Simmetrik/6DOF-Motion-Platform/README.md

# 6DOF Motion Simulator Platform

Open source DIY 6DOF Motion Simulator Platform http://www.simmetrik.com/6dof-motion-simulator-platform

Bill of materials: https://docs.google.com/spreadsheets/d/1yukbHEX3OOh7PhPTMxNBAHjRlY-1jp8z9QsD87R0PGY/edit?usp=sharing
