Simmetrik/6DOF-Motion-Platform/AASD15A Rack/Rack for AASD15A drives.step

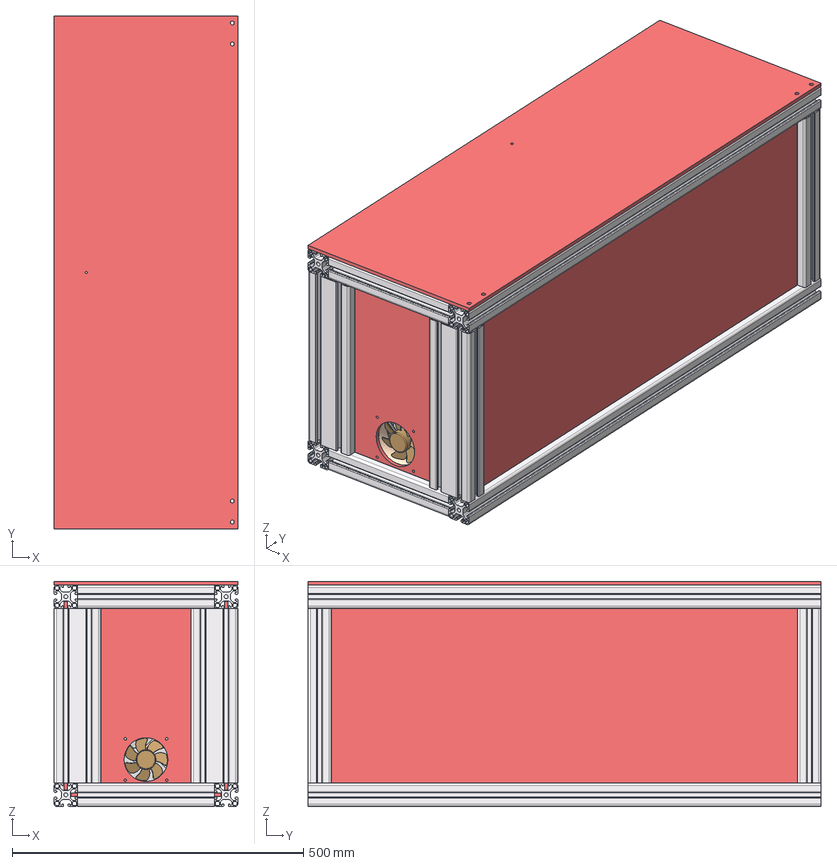
[picture p1: CAD file, 2021-11-13]
AASD15A Rack/Rack for AASD15A drives.step
315.0 x 880.0 x 386.0 mm
profile 40x40 (2) x 4
profile 80x40 (2) x 4
profile 40x40 (1) (2) (1) x 4
profile 40x40 (3)
profile 40x40 (4)
AASD15A Servo Drive (1)
AASD15A Servo Drive (7)
AASD15A Servo Drive (2)
AASD15A Servo Drive (6)
AASD15A Servo Drive (5)
AASD15A Servo Drive (4)
AASD15A Servo Drive (3)
Plexi x 2
Plexi (1)
Plexi (1) (1)
Plexi (1) (1) (2)
Plexi (1) (2)
Noctua nf-a8-pwm fan 80x80x25
Fan Baffle 80mm
