Simmetrik/6DOF-Motion-Platform/Double Traction Loss/DoubleTL UCF206 Mounting Plate.step

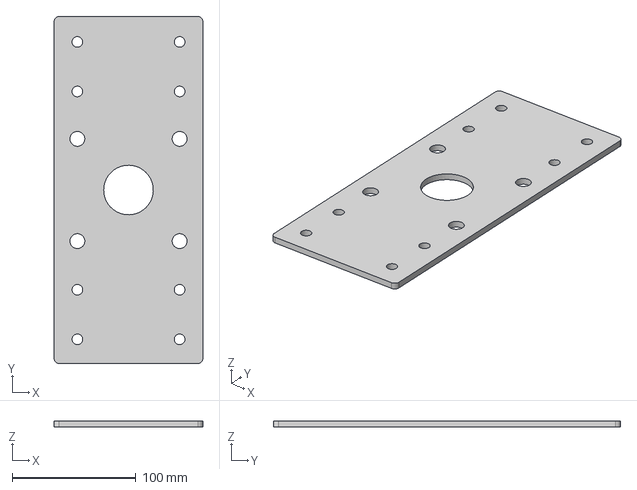
[picture p2: CAD file, 2021-11-13]
Double Traction Loss/DoubleTL UCF206 Mounting Plate.step
120.0 x 280.0 x 5.00 mm
