Simmetrik/6DOF-Motion-Platform/Surge/Surge Linear Rail Carriage Mount.step

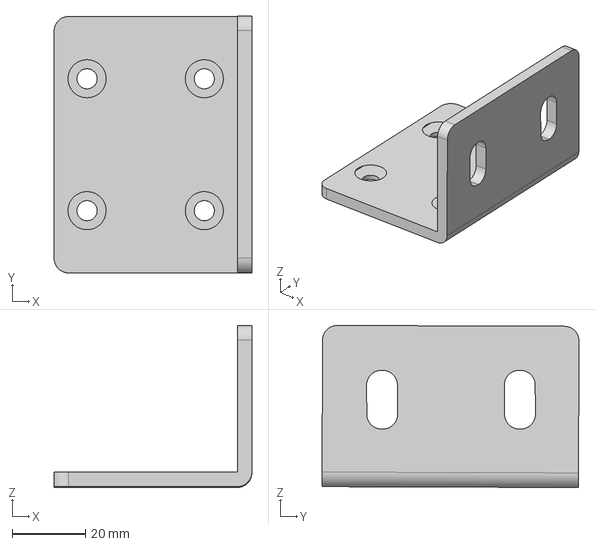
[picture p3: CAD file, 2021-11-13]
Surge/Surge Linear Rail Carriage Mount.step
54.0 x 70.1 x 44.2 mm
