Simmetrik/6DOF-Motion-Platform/Double Traction Loss/DoubleTL GX150 Linear Table Mount.step

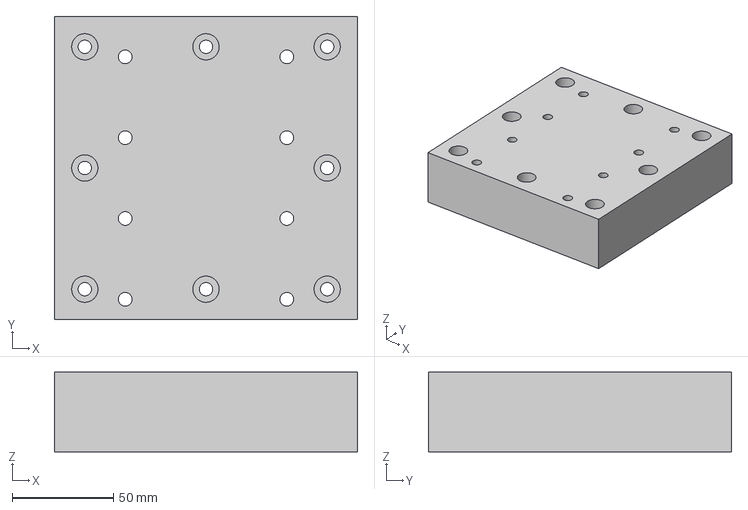
[picture p5: CAD file, 2021-11-13]
Double Traction Loss/DoubleTL GX150 Linear Table Mount.step
150.0 x 150.0 x 39.5 mm
