Simmetrik/6DOF-Motion-Platform/Surge/Surge Linear Rail Carriage Mount Spacer.step

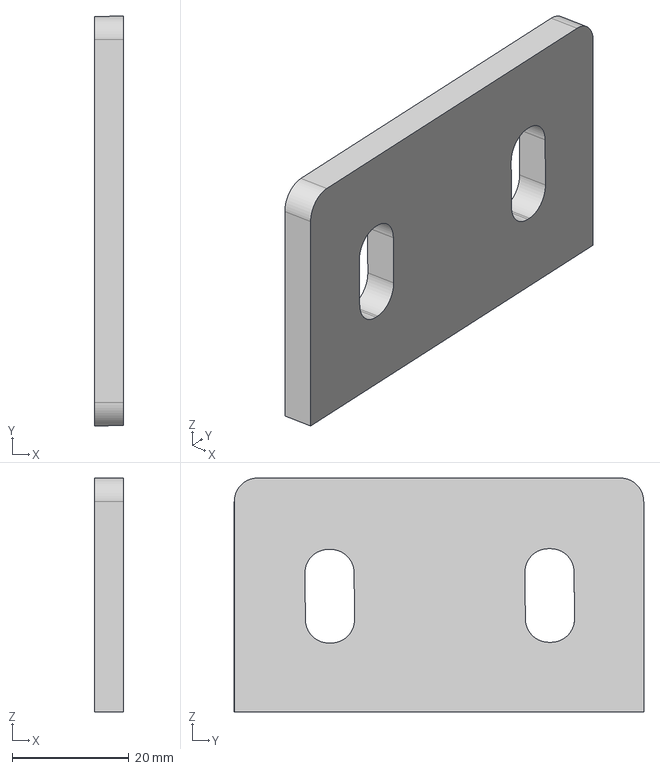
[picture p6: CAD file, 2021-11-13]
Surge/Surge Linear Rail Carriage Mount Spacer.step
5.00 x 70.0 x 40.0 mm
