Simmetrik/6DOF-Motion-Platform/Vertical Actuator/Vertical Actuator Fixed Bearing Mount CNC.step

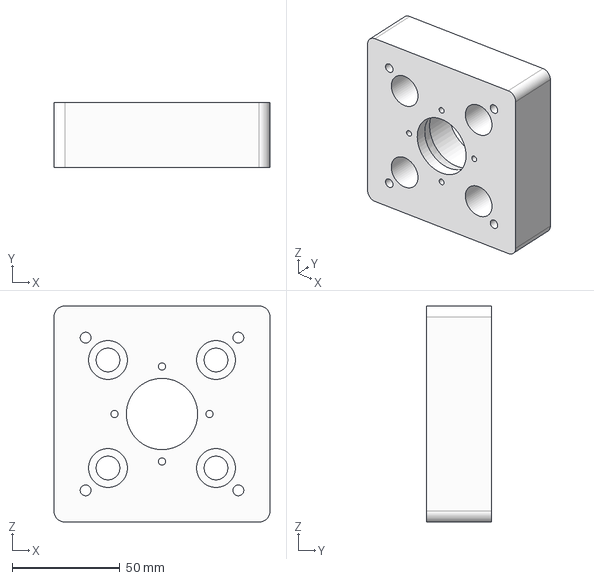
[picture p7: CAD file, 2021-11-14]
Vertical Actuator/Vertical Actuator Fixed Bearing Mount CNC.step
100.0 x 30.0 x 100.0 mm
