Simmetrik/6DOF-Motion-Platform/Double Traction Loss/DoubleTL UCF206 to SC25 Mounting Plate.step

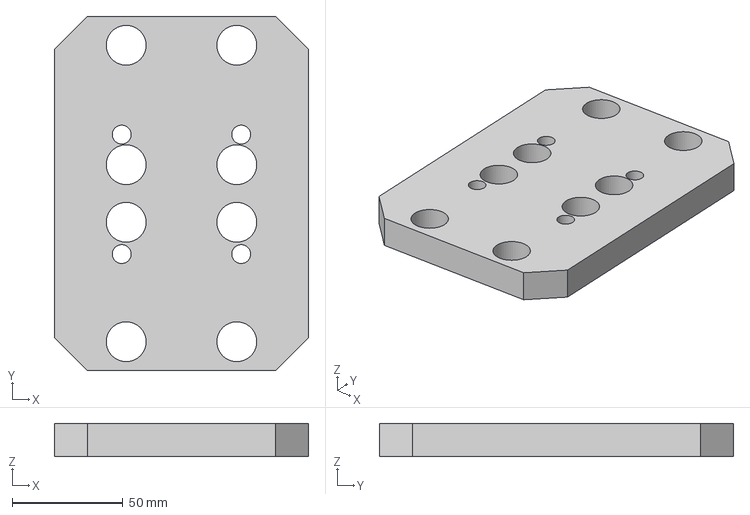
[picture p8: CAD file, 2021-11-13]
Double Traction Loss/DoubleTL UCF206 to SC25 Mounting Plate.step
115.0 x 160.0 x 15.0 mm
