Simmetrik/6DOF-Motion-Platform/Surge/Surge GX150 Linear Table Mount.step

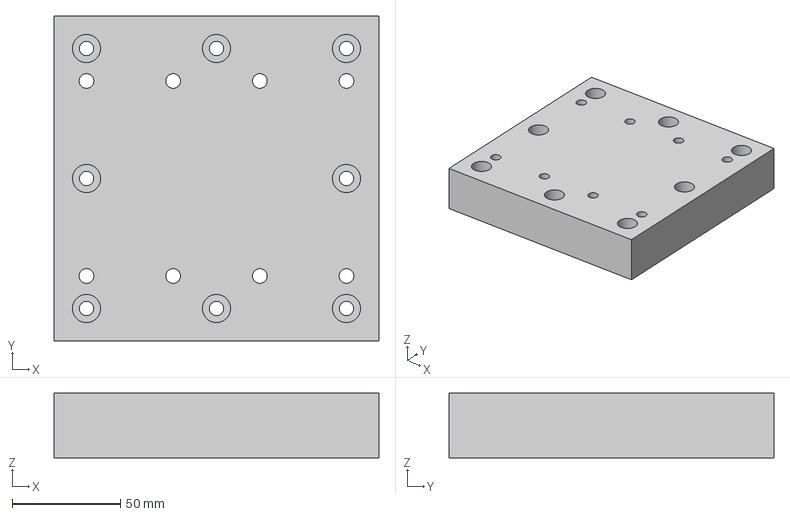
[picture p9: CAD file, 2021-11-13]
Surge/Surge GX150 Linear Table Mount.step
150.0 x 150.0 x 30.0 mm
