Simmetrik/6DOF-Motion-Platform/Vertical Actuator/Vertical Actuator Ball End.step

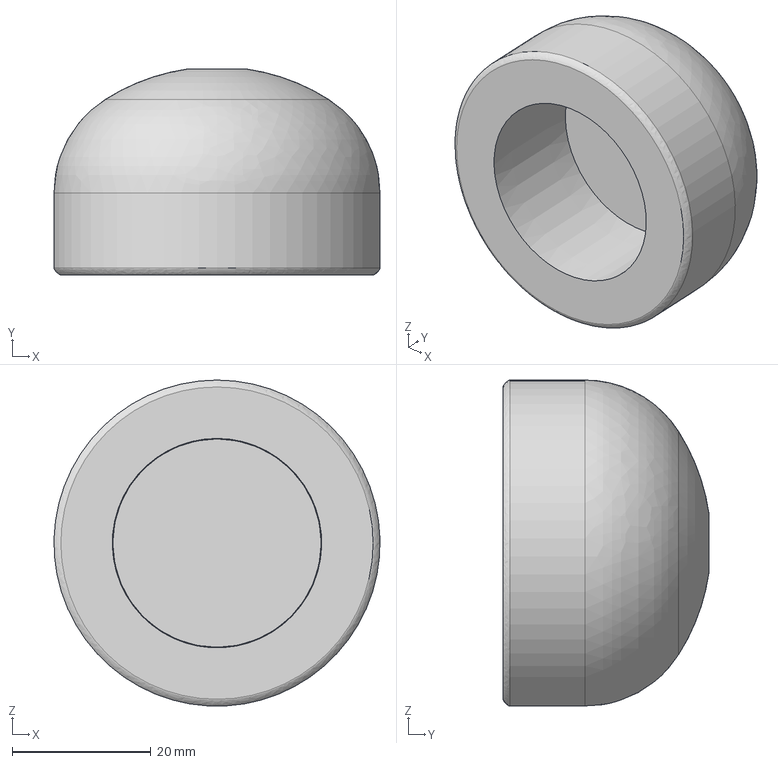
[picture p10: CAD file, 2021-11-13]
Vertical Actuator/Vertical Actuator Ball End.step
47.0 x 29.7 x 47.0 mm
