Simmetrik/6DOF-Motion-Platform/Double Traction Loss/DoubleTL Mount Thrust Bearing to 80x40 Profile.step

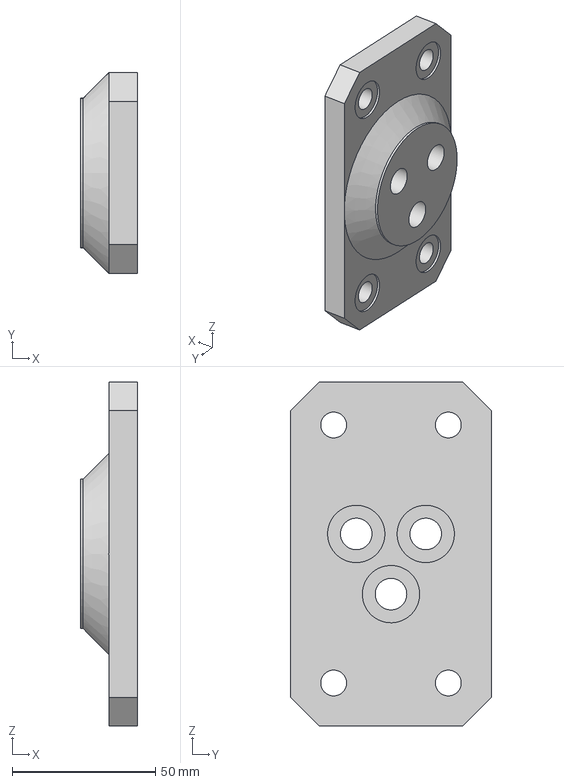
[picture p11: CAD file, 2021-11-13]
Double Traction Loss/DoubleTL Mount Thrust Bearing to 80x40 Profile.step
20.0 x 70.0 x 120.0 mm
