Simmetrik/6DOF-Motion-Platform/Vertical Actuator/Vertical Actuator Linear Bearing Mount 3dprint.step

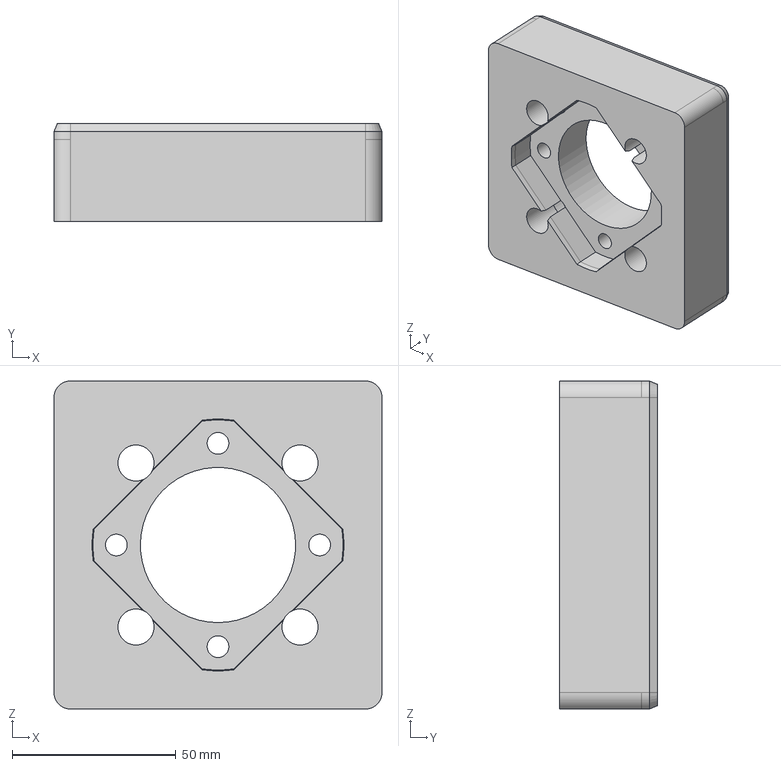
[picture p12: CAD file, 2021-11-13]
Vertical Actuator/Vertical Actuator Linear Bearing Mount 3dprint.step
100.0 x 30.0 x 100.0 mm
