Simmetrik/6DOF-Motion-Platform/Double Traction Loss/DoubleTL SurgeShaft Mount.step

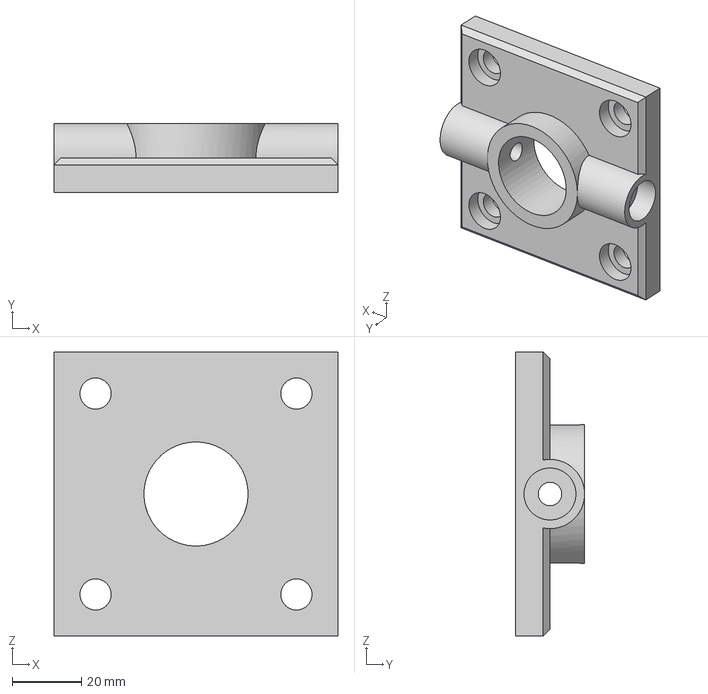
[picture p13: CAD file, 2021-11-13]
Double Traction Loss/DoubleTL SurgeShaft Mount.step
82.0 x 20.0 x 82.0 mm
