Simmetrik/6DOF-Motion-Platform/Vertical Actuator/Vertical Actuator Item Slider PushPull.step

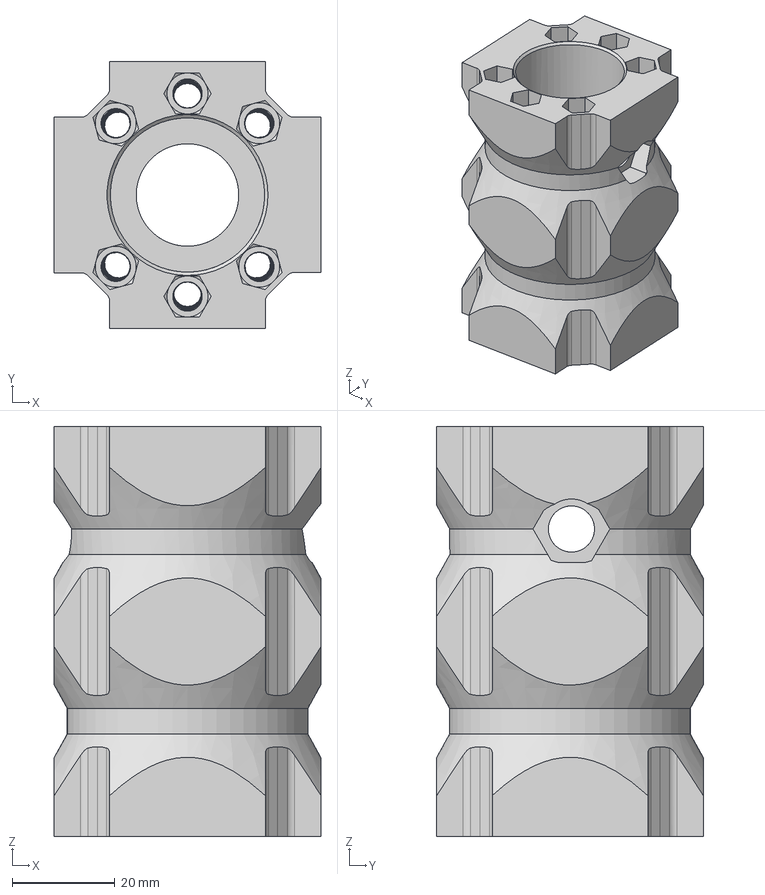
[picture p14: CAD file, 2021-11-13]
Vertical Actuator/Vertical Actuator Item Slider PushPull.step
52.0 x 52.0 x 80.0 mm
