Simmetrik/6DOF-Motion-Platform/Double Traction Loss/DoubleTL Mount Thrust Bearing to SC30 Linear Bearing.step

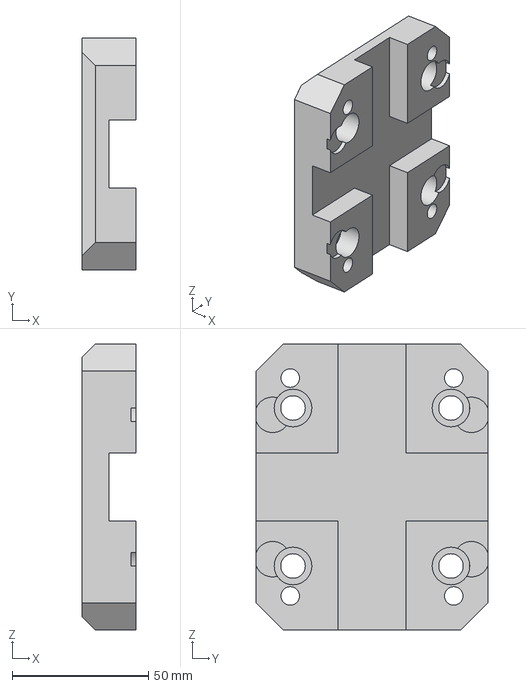
[picture p15: CAD file, 2021-11-13]
Double Traction Loss/DoubleTL Mount Thrust Bearing to SC30 Linear Bearing.step
20.0 x 85.0 x 105.0 mm
