Simmetrik/6DOF-Motion-Platform/Vertical Actuator/Vertical Actuator Mount to Surge Profile.step

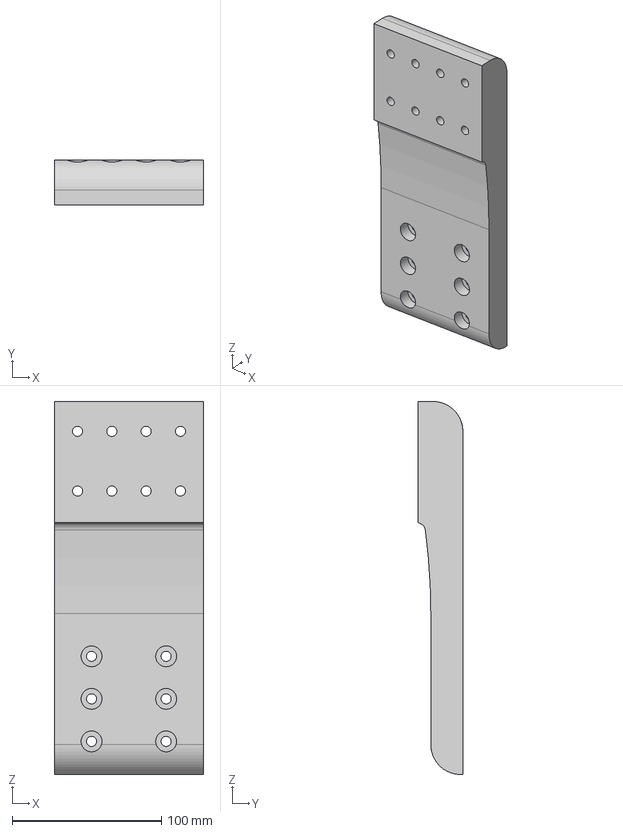
[picture p16: CAD file, 2021-11-13]
Vertical Actuator/Vertical Actuator Mount to Surge Profile.step
100.0 x 30.0 x 250.0 mm
