Simmetrik/6DOF-Motion-Platform/Vertical Actuator/Vertical Actuator Motor Mount.step

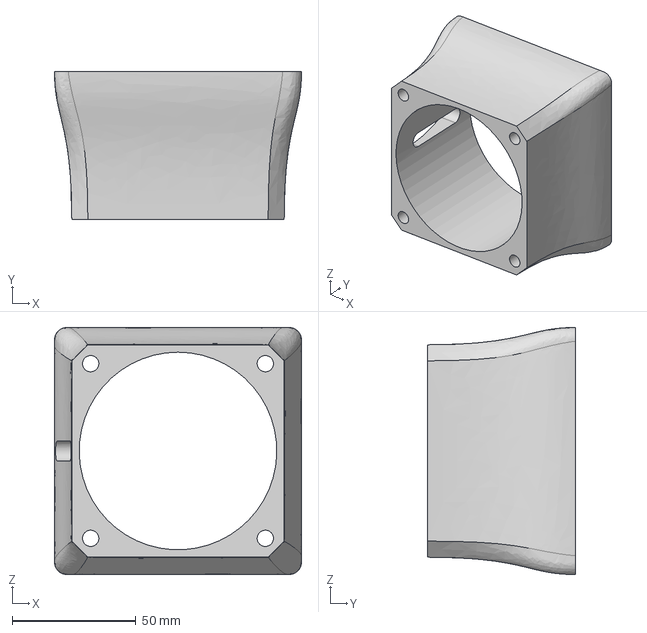
[picture p17: CAD file, 2021-11-13]
Vertical Actuator/Vertical Actuator Motor Mount.step
100.0 x 60.0 x 100.0 mm
