Simmetrik/6DOF-Motion-Platform/(list of files, cad)

Other CAD files:
Surge/Surge Linear Rail Carriage Mount Spacer.stl
Vertical Actuator/Vertical Actuator Ball End.stl
Vertical Actuator/Vertical Actuator Fixed Bearing Mount 3dprint.stl
Vertical Actuator/Vertical Actuator Item Slider PushPull.stl
Vertical Actuator/Vertical Actuator Linear Bearing Mount 3dprint.stl
Vertical Actuator/Vertical Actuator Motor Mount.stl
