Simmetrik/6DOF-Motion-Platform/(commit log)

2021-11-13 Add STEP and STL files
    [DoubleTL GX150 Linear Table Mount.step, DoubleTL Mount Thrust Bearing to 80x40 Profile.step, DoubleTL Mount Thrust Bearing to SC30 Linear Bearing.step, DoubleTL SurgeShaft Mount.step, DoubleTL UCF206 Mounting Plate.step, DoubleTL UCF206 to SC25 Mounting Plate.step, Rack for AASD15A drives.step, Surge GX150 Linear Table Mount.step]
2021-11-13 Add link to website and BOM
2021-11-13 Keep BOM in sync with 3d files
    move each GX150 35mm apart
    [Simmetrik 6DOF Motion Simulator Platform - Bill of materials.csv]
2021-11-13 Add aluminium mounting plates to BOM
    [Simmetrik 6DOF Motion Simulator Platform - Bill of materials.csv]
2021-11-13 move assembly before first column for easier diffing in BOM CSV
    [Simmetrik 6DOF Motion Simulator Platform - Bill of materials.csv]
2021-11-14 Update BOM, add casters, 3d printed and CNC parts & other missing bits
    [Simmetrik 6DOF Motion Simulator Platform - Bill of materials.csv]
2021-11-14 Add cross profile for surge GX150 mount to simrig
2021-11-14 update BOM with mentions to 80x80 & non-light version profile for extra stiffness
    to replace the 40x80 light frame profiles for Yaw-Sway top and Surge frames
    [Simmetrik 6DOF Motion Simulator Platform - Bill of materials.csv]
2021-11-14 Add CNC machined fixed and linear bearing mount options for vertical actuator
    [Simmetrik 6DOF Motion Simulator Platform - Bill of materials.csv, Vertical Actuator Fixed Bearing Mount 3dprint.step, Vertical Actuator Fixed Bearing Mount 3dprint.stl, Vertical Actuator Fixed Bearing Mount CNC.step, Vertical Actuator Fixed Bearing Mount.step, Vertical Actuator Fixed Bearing Mount.stl, Vertical Actuator Linear Bearing Mount 3dprint.step, Vertical Actuator Linear Bearing Mount 3dp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]
2021-11-22 fix typos in BOM
    [Simmetrik 6DOF Motion Simulator Platform - Bill of materials.csv]
2021-11-26 match STEP file names for CNC machined parts in BOM
    [Simmetrik 6DOF Motion Simulator Platform - Bill of materials.csv, Vertical Actuator Mount to Surge Profile.step]
2025-07-06 update BOM link
